RiceShelley/diyve/(commit log)

2025-12-18 WIP: rough prototype of dive logger + RTC
2026-02-07 Finished mechanical design
    [button_holder.scad, main_holder.scad, plastic_clip.scad, pressure_sensor_enclosure.scad]
